charleslindsay/SMA_Driver_PCB/PCB Board Files V1/Board Top.jpg

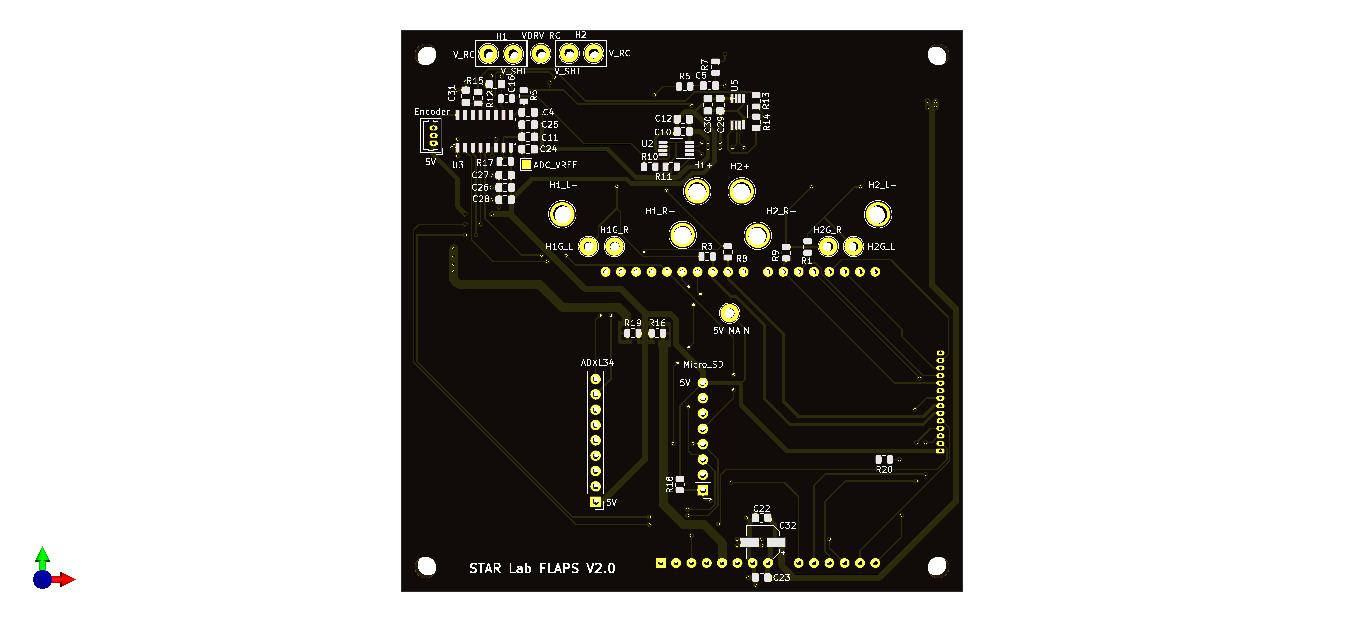
PCB Board Files V1/Board Top.jpg
