charleslindsay/SMA_Driver_PCB/BOM V2/BOM_Digikey_Order_01.11.19.xlsx

# | Quantity | Part Number | Manufacturer Part Number | Description | Customer Reference | Backorder | Unit Price | Extended Price
1 | 5 | P4.0MCT-ND | ERJ-M1WSF4M0U | RES 0.004 OHM 1% 1W 2512 |  | 0 | 0.7 | 3.50
2 | 5 | P6.0MCT-ND | ERJ-M1WSF6M0U | RES 0.006 OHM 1% 1W 2512 |  | 0 | 0.7 | 3.50
3 | 4 | NVMFS5C404NLAFT1GOSCT-ND | NVMFS5C404NLAFT1G | MOSFET N-CH 40V 370A 5DFN |  | 0 | 4.13 | 16.52
4 | 10 | 311-124CRCT-ND | RC0805FR-07124RL | RES SMD 124 OHM 1% 1/8W 0805 |  | 0 | 0.043 | 0.43
5 | 2 | 296-41265-1-ND | INA332AIDGKR | IC OPAMP INSTR 2MHZ RRO 8VSSOP |  | 0 | 1.61 | 3.22
6 | 1 | 555-1256-1-ND | UDT020A0X3-SRZ | DC DC CONVERTER 0.5-5.5V 20A |  | 0 | 17.33 | 17.33
7 | 10 | RHM1.00KAECT-ND | ESR10EZPF1001 | RES SMD 1K OHM 1% 0.4W 0805 |  | 0 | 0.146 | 1.46
8 | 5 | P24KDACT-ND | ERA-6AEB243V | RES SMD 24K OHM 0.1% 1/8W 0805 |  | 0 | 0.36 | 1.80
9 | 5 | P22KDACT-ND | ERA-6AEB223V | RES SMD 22K OHM 0.1% 1/8W 0805 |  | 0 | 0.36 | 1.80
10 | 5 | P20KDACT-ND | ERA-6AEB203V | RES SMD 20K OHM 0.1% 1/8W 0805 |  | 0 | 0.36 | 1.80
11 | 5 | P30KDACT-ND | ERA-6AEB303V | RES SMD 30K OHM 0.1% 1/8W 0805 |  | 0 | 0.36 | 1.80
12 | 5 | P33KDACT-ND | ERA-6AEB333V | RES SMD 33K OHM 0.1% 1/8W 0805 |  | 0 | 0.36 | 1.80
13 | 5 | P27KDACT-ND | ERA-6AEB273V | RES SMD 27K OHM 0.1% 1/8W 0805 |  | 0 | 0.36 | 1.80
14 | 5 | P36KDACT-ND | ERA-6AEB363V | RES SMD 36K OHM 0.1% 1/8W 0805 |  | 0 | 0.36 | 1.80
15 | 1 | MCP3208T-BI/SLCT-ND | MCP3208T-BI/SL | IC ADC 12BIT 2.7V 8CH SPI 16SOIC |  | 0 | 4.48 | 4.48
16 | 3 | 541-0.0TBCT-ND | CRCW08050000Z0EAHP | RES SMD 0 OHM JUMPER 1/2W 0805 |  | 0 | 0.25 | 0.75
17 | 6 | 718-2181-1-ND | T55D337M6R3C0012 | CAP TANT POLY 330UF 6.3V 2917 |  | 0 | 2.03 | 12.18
18 | 5 | 1276-1852-1-ND | CL21A476MQYNNNE | CAP CER 47UF 6.3V X5R 0805 |  | 0 | 0.6 | 3.00
19 | 10 | RTAN0805BKE180RCT-ND | RTAN0805BKE180R | RES 180 OHM 0.1% 1/5W 0805 |  | 0 | 0.485 | 4.85
20 | 10 | 399-7995-1-ND | C0805C103K4RACTU | CAP CER 10000PF 16V X7R 0805 |  | 0 | 0.13 | 1.30
21 | 5 | 1276-2908-1-ND | CL21A226MAQNNNE | CAP CER 22UF 25V X5R 0805 |  | 0 | 1.05 | 5.25
22 | 5 | 709-1183-1-ND | 160R15W104KV4T | CAP CER 0.1UF 16V X7R 0805 |  | 0 | 0.23 | 1.15
23 | 5 | 1276-2873-1-ND | CL21B475KOFNNNE | CAP CER 4.7UF 16V X7R 0805 |  | 0 | 0.34 | 1.70
24 | 1 | 1528-1015-ND | 1231 | ADXL345 3AXIS ACCEL BREAKOUT BRD |  | 0 | 17.5 | 17.50
25 | 1 | 1528-1462-ND | 254 | MICROSD CARD BREAKOUT 5V OR 3V |  | 0 | 7.5 | 7.50
26 | 5 | RNCF0805DTE10K0CT-ND | RNCF0805DTE10K0 | RES 10K OHM 0.5% 1/8W 0805 |  | 0 | 0.17 | 0.85
27 | 3 | WM17004-ND | 0530471410 | CONN HEADER VERT 14POS 1.25MM |  | 0 | 1.24 | 3.72
28 | 2 | WM1732-ND | 0530470310 | CONN HEADER VERT 3POS 1.25MM |  | 0 | 0.44 | 0.88
29 | 8 | 36-5006-ND | 5006 | PC TEST POINT COMPACT BLACK |  | 0 | 0.33 | 2.64
30 | 5 | PCE3947CT-ND | EEE-1VA100SR | CAP ALUM 10UF 20% 35V SMD |  | 0 | 0.31 | 1.55
31 | 1 | WM17238-ND | 0151341405 | PICOBLADE 14 CIRCUIT 450MM |  | 0 | 6.37 | 6.37
32 | 2 | Z5376-ND | XG8V-0831 | CONN HEADER VERT 8POS 2.54MM |  | 0 | 0.53 | 1.06
33 | 2 | 732-2670-ND | 61301011121 | CONN HEADER VERT 10POS 2.54MM |  | 0 | 0.89 | 1.78
34 | 2 | 732-5319-ND | 61300611121 | CONN HEADER VERT 6POS 2.54MM |  | 0 | 0.33 | 0.66
35 | 2 | WM15255-ND | 0151340303 | PICOBLADE 3 CIRCUIT 300MM |  | 0 | 2.8 | 5.60
36 | 5 | 754-1535-1-ND | AA3528VRVFS/A | LED PURPLE CLEAR SMD |  | 0 | 0.8 | 4.00
37 | 10 | RR12P100DCT-ND | RR1220P-101-D | RES SMD 100 OHM 0.5% 1/10W 0805 |  | 0 | 0.098 | 0.98
38 | 10 | 1497-1436-1-ND | XZCBD54W-8 | LED BLUE CLEAR CHIP SMD |  | 0 | 0.454 | 4.54
39 | 5 | 404-1267-1-ND | FKA1112H-TR | LED ORANGE DIFFUSED SMD |  | 0 | 0.5 | 2.50
40 | 5 | RHM220KCT-ND | ESR10EZPJ221 | RES SMD 220 OHM 5% 0.4W 0805 |  | 0 | 0.1 | 0.50
41 | 5 | 1497-1434-1-ND | XZVG54W-8 | LED GREEN CLEAR CHIP SMD |  | 0 | 0.43 | 2.15
42 | 10 | 754-1438-1-ND | APT2012ZGC | LED GREEN CLEAR CHIP SMD |  | 0 | 0.568 | 5.68
43 | 10 | 754-1791-1-ND | APT2012SECK/J3-PRV | LED RED CLEAR CHIP SMD |  | 0 | 0.397 | 3.97
44 | 3 | CT3016-ND | 282T33L502A25C2 | POT 5K OHM 1/4W PLASTIC LINEAR |  | 0 | 13.35 | 40.05
45 | 3 | 1722-1185-ND | 1930BQ | KNOB FLUTED W/SKIRT 0.250" PHEN |  | 0 | 3.59 | 10.77
46 | 3 | 1740-1151-ND | BYC8-600P,127 | DIODE GEN PURP 600V 8A TO220AC |  | 0 | 0.79 | 2.37
47 | 10 | 311-160ARCT-ND | RC0805JR-07160RL | RES SMD 160 OHM 5% 1/8W 0805 |  | 0 | 0.037 | 0.37
 |  |  |  |  |  |  | Total | 221.21
