charleslindsay/SMA_Driver_PCB/BOM V2/BOM_Digikey_Order_01.30.19.xlsx

# | Quantity | Part Number | Manufacturer Part Number | Description | Customer Reference | Backorder | Unit Price | Extended Price
1 | 1 | WM17238-ND | 0151341405 | PICOBLADE 14 CIRCUIT 450MM |  | 0 | 6.37 | 6.37
2 | 1 | Q1193-ND | QADA-50-12-1401 | AC/DC DESKTOP ADAPTER 12V 50W |  | 0 | 18.73 | 18.73
3 | 1 | T1247-C13-JP-ND | AC-C13 JP | CORD NEMA5-15P - IEC 320-C13 6' |  | 0 | 5.81 | 5.81
4 | 1 | WM17239-ND | 0151341406 | CABLE ASSY RECT 14POS SKT TO SKT |  | 0 | 6.75 | 6.75
