charleslindsay/SMA_Driver_PCB/BOM V2/FLAPS BOM V2.0 (1xPCB).xlsx

Quantity | Ref | Value | Order Link | Footprint | Component | Price per comp | Total Price
2 | R2,R4 | 4m | https://www.digikey.com/product-detail/en/panasonic-electronic-components/ERJ-M1WSF4M0U/P4.0MCT-ND/300470 | Resistor_SMD:R_2512_6332Metric_Pad1.52x3.35mm_HandSolder | Resistor
 | " | 6m | https://www.digikey.com/product-detail/en/panasonic-electronic-components/ERJ-M1WSF6M0U/P6.0MCT-ND/966294
4 | Q1,Q2,Q3,Q4 | Q_NMOS_GDS | https://www.digikey.com/product-detail/en/on-semiconductor/NVMFS5C404NLAFT1G/NVMFS5C404NLAFT1GOSCT-ND/7066790 | custom:SO-8FL_v2 | N-MOSFET transistor, gate/drain/source
4 | R3,R8,R1,R9 | 125 | https://www.digikey.com/product-detail/en/yageo/RC0805FR-07124RL/311-124CRCT-ND/730526 | Resistor_SMD:R_0805_2012Metric | Resistor
2 | U2 | INA332 | https://www.digikey.com/product-detail/en/texas-instruments/INA332AIDGKR/296-41265-1-ND/5222729 | Package_SO:VSSOP-8_3.0x3.0mm_P0.65mm
1 | U1 | UDT020A0X3-SRZ | https://www.digikey.com/product-detail/en/ge-critical-power/UDT020A0X3-SRZ/555-1256-1-ND/2665527 | custom:UDT020A0X3-SRZ
2 | R11,R14 | 1k | https://www.digikey.com/product-detail/en/rohm-semiconductor/ESR10EZPF1001/RHM1.00KAECT-ND/1983804 | Resistor_SMD:R_0805_2012Metric | Resistor
2 | R10,R13 | 24k | https://www.digikey.com/product-detail/en/panasonic-electronic-components/ERA-6AEB243V/P24KDACT-ND/1465980 | Resistor_SMD:R_0805_2012Metric | Resistor
 | " | 22k | https://www.digikey.com/product-detail/en/panasonic-electronic-components/ERA-6AEB223V/P22KDACT-ND/1465979
 | " | 20k | https://www.digikey.com/product-detail/en/panasonic-electronic-components/ERA-6AEB203V/P20KDACT-ND/1465978
 | " | 30k | https://www.digikey.com/product-detail/en/panasonic-electronic-components/ERA-6AEB303V/P30KDACT-ND/1465982
 | " | 33k | https://www.digikey.com/product-detail/en/panasonic-electronic-components/ERA-6AEB333V/P33KDACT-ND/1465983
 | " | 27k | https://www.digikey.com/product-detail/en/panasonic-electronic-components/ERA-6AEB273V/P27KDACT-ND/1465981
 | " | 36k | https://www.digikey.com/product-detail/en/panasonic-electronic-components/ERA-6AEB363V/P36KDACT-ND/1465984
1 | R12 | 30k | https://www.digikey.com/product-detail/en/panasonic-electronic-components/ERA-6AEB303V/P30KDACT-ND/1465982 | Resistor_SMD:R_0805_2012Metric | Resistor
2 | C4,C16 | 1uF | https://www.digikey.com/product-detail/en/kemet/C0805C105J4RACTU/399-8001-1-ND/3471724 | Capacitor_SMD:C_0805_2012Metric_Pad1.15x1.40mm_HandSolder | Unpolarized capacitor
2 | R5,R7 | 15.8k | https://www.digikey.com/product-detail/en/panasonic-electronic-components/ERA-6AEB1582V/P15.8KDACT-ND/3074972 | Resistor_SMD:R_0805_2012Metric | Resistor
1 | U3 | MCP3208 | https://www.digikey.com/product-detail/en/microchip-technology/MCP3208T-BI-SL/MCP3208T-BI-SLCT-ND/8628836 | digikey-footprints:SOIC-16_W3.90mm | A/D Converter, 12-Bit, 8-Channel, SPI Interface , 2.7V-5.5V
3 | R16,R17,R19 | 0 | https://www.digikey.com/product-detail/en/vishay-dale/CRCW08050000Z0EAHP/541-0.0TBCT-ND/2222831 | Resistor_SMD:R_0805_2012Metric | Resistor
8 | C13-21 | 330u | https://www.digikey.com/product-detail/en/vishay-sprague/T55D337M6R3C0012/718-2181-1-ND/6230411 | Capacitor_Tantalum_SMD:CP_EIA-7343-43_Kemet-X_Pad2.25x2.55mm_HandSolder | Unpolarized capacitor
2 | C6,C7 | 47uF | https://www.digikey.com/product-detail/en/samsung-electro-mechanics/CL21A476MQYNNNE/1276-1852-1-ND/3889938 | Capacitor_SMD:C_0805_2012Metric_Pad1.15x1.40mm_HandSolder | Unpolarized capacitor
1 | R6 | 180 | https://www.digikey.com/product-detail/en/stackpole-electronics-inc/RTAN0805BKE180R/RTAN0805BKE180RCT-ND/6602252 | Resistor_SMD:R_0805_2012Metric | Resistor
3 | C5,C11,C28 | 10n | https://www.digikey.com/product-detail/en/kemet/C0805C103K4RACTU/399-7995-1-ND/3471718 | Capacitor_SMD:C_0805_2012Metric_Pad1.15x1.40mm_HandSolder | Unpolarized capacitor
3 | C1-3 | 22uF | https://www.digikey.com/product-detail/en/samsung-electro-mechanics/CL21A226MAQNNNE/1276-2908-1-ND/3890994 | Capacitor_SMD:C_0805_2012Metric_Pad1.15x1.40mm_HandSolder | Unpolarized capacitor
4 | C10,C23,C24,C27 | 100n | https://www.digikey.com/product-detail/en/johanson-dielectrics-inc/160R15W104KV4T/709-1183-1-ND/1859515 | Capacitor_SMD:C_0805_2012Metric_Pad1.15x1.40mm_HandSolder | Unpolarized capacitor
3 | C12,C25,C26 | 4.7u | https://www.digikey.com/product-detail/en/samsung-electro-mechanics/CL21B475KOFNNNE/1276-2873-1-ND/3890959 | Capacitor_SMD:C_0805_2012Metric_Pad1.15x1.40mm_HandSolder | Unpolarized capacitor
1 | A2 | ADXL34_Accelerometer | https://www.digikey.com/product-detail/en/adafruit-industries-llc/1231/1528-1015-ND/4990764 | Connector_PinHeader_2.54mm:PinHeader_1x09_P2.54mm_Vertical
1 | U4 | MicroSD_Breakout_ADF | https://www.digikey.com/products/en?mpart=254&v=1528 | Connector_PinHeader_2.54mm:PinHeader_1x08_P2.54mm_Vertical
1 | R18 | 10k | https://www.digikey.com/product-detail/en/stackpole-electronics-inc/RNCF0805DTE10K0/RNCF0805DTE10K0CT-ND/2687083 | Resistor_SMD:R_0805_2012Metric | Resistor
1 | J1 | Human_Interface_Tether | https://www.digikey.com/products/en/connectors-interconnects/rectangular-connectors-headers-male-pins/314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 | Connector_Molex:Molex_PicoBlade_53047-2810_1x14_P1.25mm_Vertical | Generic connector, single row, 01x14, script generated (kicad-library-utils/schlib/autogen/connector/)
1 | J2 | RM08V_Conn | https://www.digikey.com/products/en/connectors-interconnects/rectangular-connectors-headers-male-pins/314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 | Connector_Molex:Molex_PicoBlade_53047-0610_1x03_P1.25mm_Vertical | Generic connector, single row, 01x03, script generated (kicad-library-utils/schlib/autogen/connector/)
8 | TP6, TP4, TP14, TP19, TP7, TP17, TP20, TP21 | Gate_2 | https://www.digikey.com/product-detail/en/keystone-electronics/5006/36-5006-ND/255330 | TestPoint:TestPoint_Loop_D2.60mm_Drill1.6mm_Beaded | test point
3 | C8,C9,C32 | 10uF | https://www.digikey.com/product-detail/en/panasonic-electronic-components/EEE-1VA100SR/PCE3947CT-ND/766323 | Capacitor_SMD:CP_Elec_5x5.3 | Unpolarized capacitor
2 | C30,C22 | 4.7u | https://www.digikey.com/product-detail/en/samsung-electro-mechanics/CL21B475KOFNNNE/1276-2873-1-ND/3890959 | Capacitor_SMD:C_0805_2012Metric_Pad1.15x1.40mm_HandSolder | Unpolarized capacitor
1 | NA | Tether Cable | https://www.digikey.com/product-detail/en/molex-llc/0151341405/WM17238-ND/7929163
2 | NA | 8 pin header | https://www.digikey.com/products/en?keywords=Z5376-ND
1 | NA | 10 pin header | https://www.digikey.com/products/en?keywords=732-2670-ND
1 | NA | 6 pin header | https://www.digikey.com/products/en?keywords=732-5319-ND
1 | NA | Encoder Cable | https://www.digikey.com/products/en/cable-assemblies/rectangular-cable-assemblies/450?k=015134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
