charleslindsay/SMA_Driver_PCB/SMA_Driver_V1.kicad_pcb

## KiCad design SMA_Driver_V1.kicad_pcb (2019-01-10)

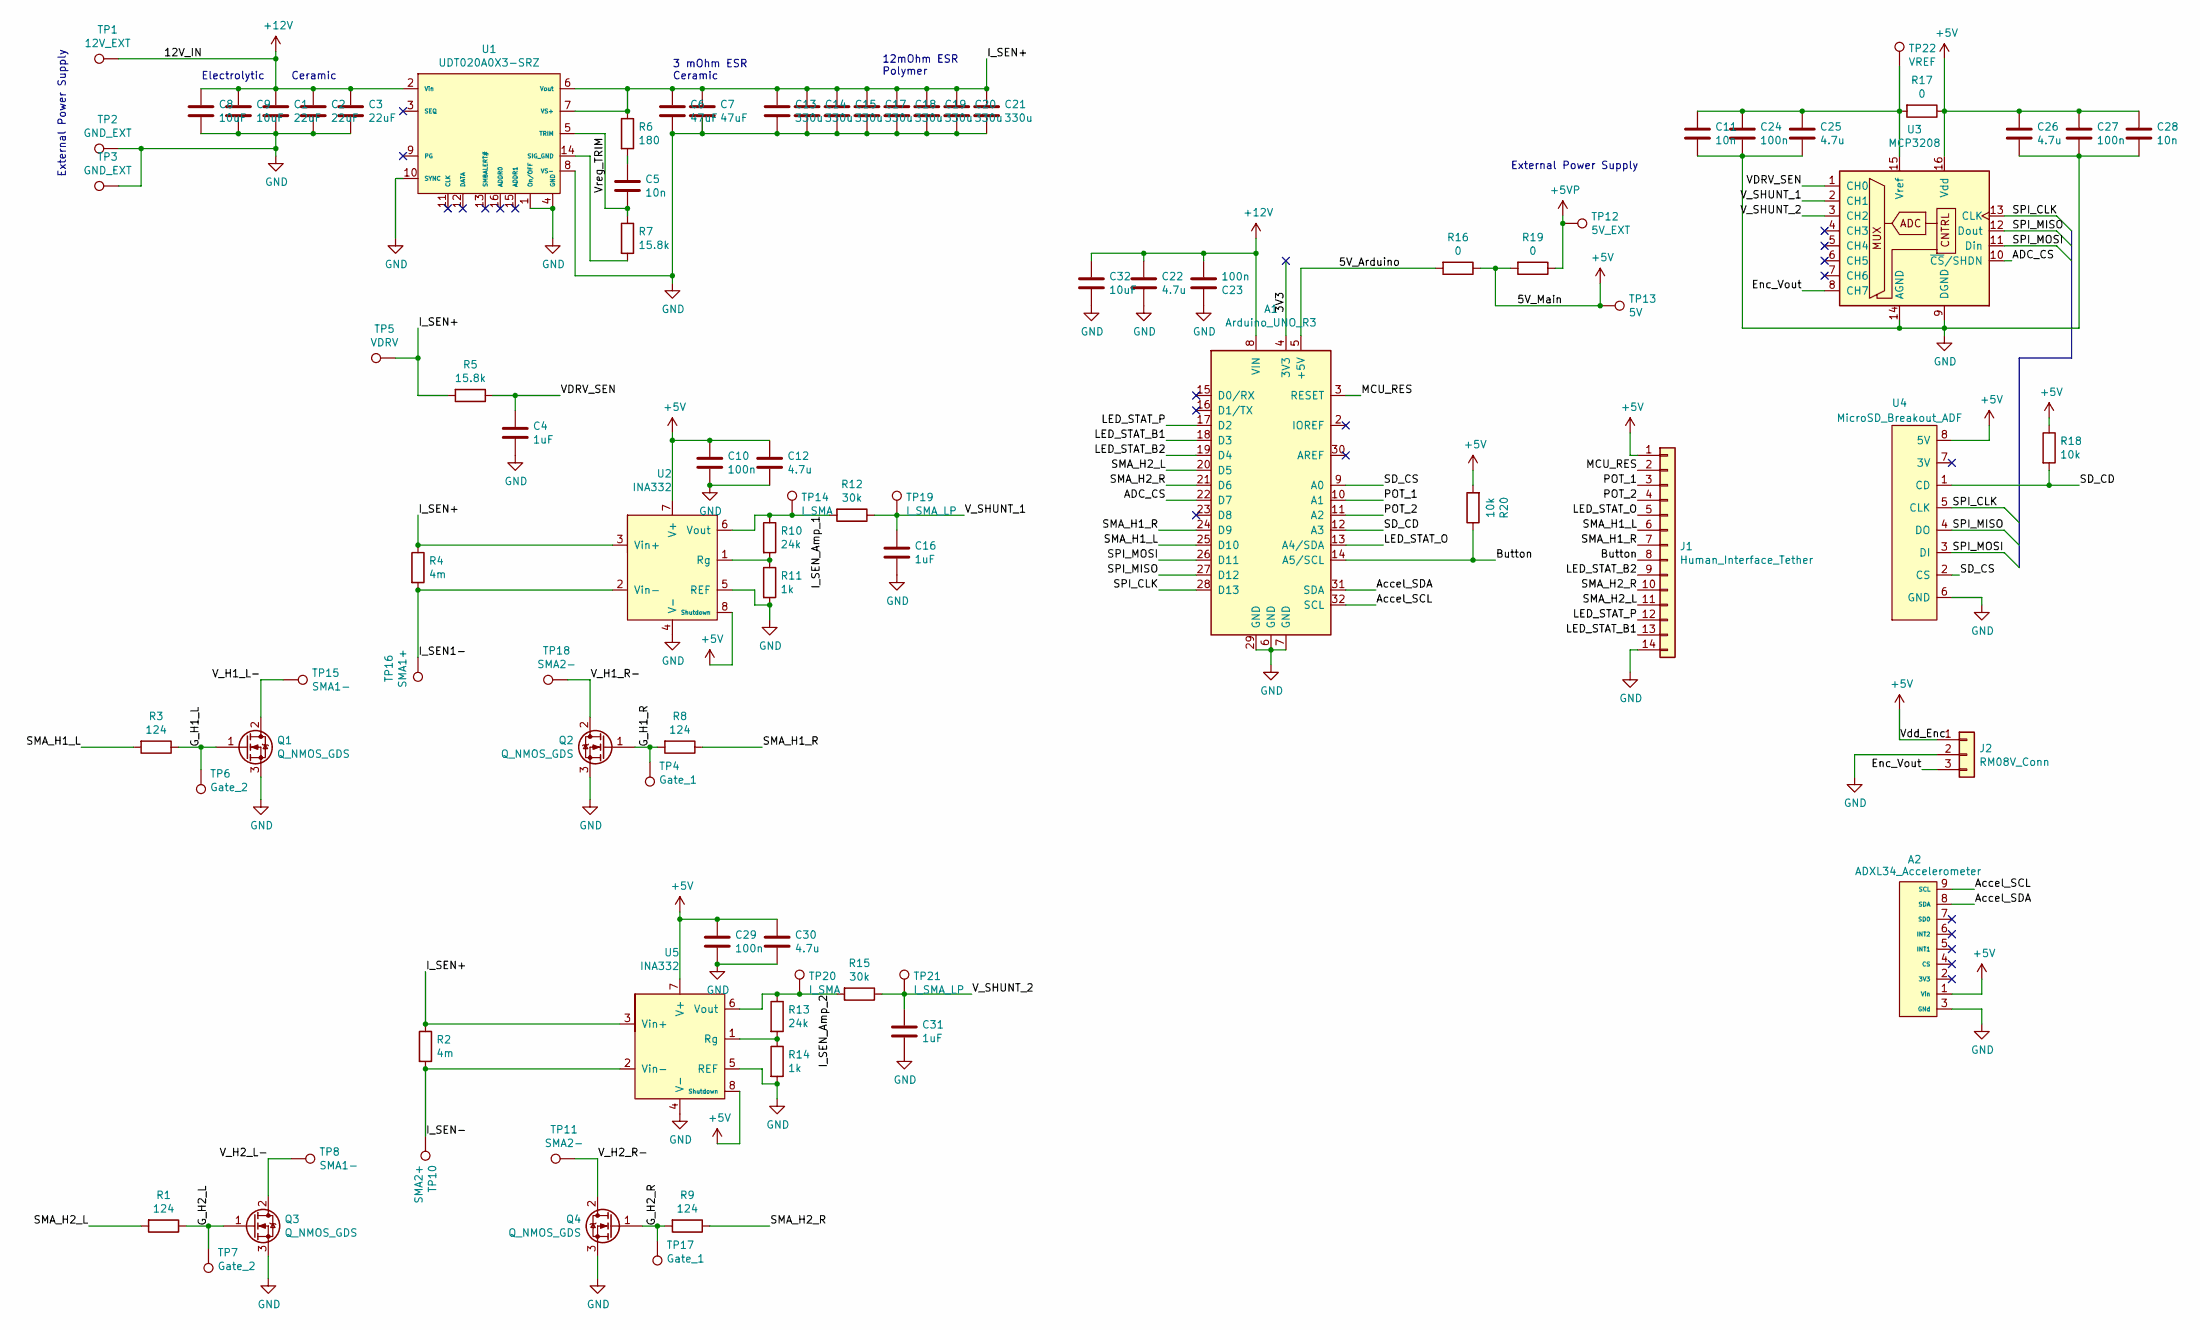
[picture p2: schematic SMA_Driver_V1.sch, SMA Driver]

Parts:
A1: Arduino_UNO_R3
A2: ADXL34_Accelerometer; PinHeader_1x09_P2.54mm_Vertical
C1, C2, C3: 22uF; C_0805_2012Metric_Pad1.15x1.40mm_HandSolder
C4, C16, C31: 1uF; C_0805_2012Metric_Pad1.15x1.40mm_HandSolder
C5, C11, C28: 10n; C_0805_2012Metric_Pad1.15x1.40mm_HandSolder
C6, C7: 47uF; C_0805_2012Metric_Pad1.15x1.40mm_HandSolder
C8, C9, C32: 10uF; CP_Elec_5x5.3
C10, C23, C24, C27, C29: 100n; C_0805_2012Metric_Pad1.15x1.40mm_HandSolder
C12, C22, C25, C26, C30: 4.7u; C_0805_2012Metric_Pad1.15x1.40mm_HandSolder
C13, C14, C15, C17, C18, C19, C20, C21: 330u; CP_EIA-7343-43_Kemet-X_Pad2.25x2.55mm_HandSolder
J1: Human_Interface_Tether; Molex_PicoBlade_53047-2810_1x14_P1.25mm_Vertical
J2: RM08V_Conn; Molex_PicoBlade_53047-0610_1x03_P1.25mm_Vertical
Q1, Q2, Q3, Q4: Q_NMOS_GDS; SO-8FL_v2
R1, R3, R8, R9: 124; R_0805_2012Metric
R2, R4: 4m; R_2512_6332Metric_Pad1.52x3.35mm_HandSolder
R5, R7: 15.8k; R_0805_2012Metric
R6: 180; R_0805_2012Metric
R10, R13: 24k; R_0805_2012Metric
R11, R14: 1k; R_0805_2012Metric
R12, R15: 30k; R_0805_2012Metric
R16, R17, R19: 0; R_0805_2012Metric
R18, R20: 10k; R_0805_2012Metric
TP1: 12V_EXT; TestPoint_Pad_4.0x4.0mm
TP2, TP3: GND_EXT; TestPoint_Pad_4.0x4.0mm
TP4, TP17: Gate_1; TestPoint_Loop_D2.60mm_Drill1.6mm_Beaded
TP5: VDRV; TestPoint_Loop_D2.60mm_Drill1.6mm_Beaded
TP6, TP7: Gate_2; TestPoint_Loop_D2.60mm_Drill1.6mm_Beaded
TP8, TP15: SMA1-; TestPoint_Plated_Hole_D3.0mm
TP10: SMA2+; TestPoint_Plated_Hole_D3.0mm
TP11, TP18: SMA2-; TestPoint_Plated_Hole_D3.0mm
TP12: 5V_EXT; TestPoint_Pad_4.0x4.0mm
TP13: 5V; TestPoint_Loop_D2.60mm_Drill1.6mm_Beaded
TP14, TP20: I_SMA; TestPoint_Loop_D2.60mm_Drill1.6mm_Beaded
TP16: SMA1+; TestPoint_Plated_Hole_D3.0mm
TP19, TP21: I_SMA_LP; TestPoint_Loop_D2.60mm_Drill1.6mm_Beaded
TP22: VREF; TestPoint_Pad_1.5x1.5mm
U1: UDT020A0X3-SRZ
U2, U5: INA332; VSSOP-8_3.0x3.0mm_P0.65mm
U3: MCP3208; SOIC-16_W3.90mm
U4: MicroSD_Breakout_ADF; PinHeader_1x08_P2.54mm_Vertical

Connections:
+5V: A2.1 (Vin), C10.1, C12.1, C26.1, C27.1, C28.1, C29.1, C30.1, J1.1, J2.1, R16.1, R17.1, R18.1, R19.2, R20.2, TP13.1, U2.7 (V+), U2.8 (Shutdown), U3.16 (Vdd), U4.8 (5V), U5.7 (V+), U5.8 (Shutdown)
+5VP: R19.1, TP12.1
+12V: A1.8 (VIN), C1.1, C2.1, C3.1, C8.1, C9.1, C22.1, C23.2, C32.1, TP1.1, U1.2 (Vin)
/3V3: A1.4 (3V3)
/5V_Arduino: A1.5 (+5V), R16.2
/ADC_CS: A1.22 (D7), U3.10 (~CS~/SHDN)
/Accel_SCL: A1.32 (SCL), A2.9 (SCL)
/Accel_SDA: A1.31 (SDA), A2.8 (SDA)
/Button: A1.14 (A5/SCL), J1.8, R20.1
/Enc_Vout: J2.3, U3.8 (CH7)
/G_H1_L: Q1.1 (G), R3.1, TP6.1
/G_H1_R: Q2.1 (G), R8.2, TP4.1
/G_H2_L: Q3.1 (G), R1.1, TP7.1
/G_H2_R: Q4.1 (G), R9.2, TP17.1
/I_SEN1-: R4.2, TP16.1, U2.2 (Vin-)
/I_SEN+: C6.1, C7.1, C13.1, C14.1, C15.1, C17.1, C18.1, C19.1, C20.1, C21.1, R2.1, R4.1, R5.2, R6.1, TP5.1, U1.6 (Vout), U1.7 (VS+), U2.3 (Vin+), U5.3 (Vin+)
/I_SEN-: R2.2, TP10.1, U5.2 (Vin-)
/I_SEN_Amp_1: R10.1, R12.2, TP14.1, U2.6 (Vout)
/I_SEN_Amp_2: R13.1, R15.2, TP20.1, U5.6 (Vout)
/LED_STAT_B1: A1.18 (D3), J1.13
/LED_STAT_B2: A1.19 (D4), J1.9
/LED_STAT_O: A1.13 (A4/SDA), J1.5
/LED_STAT_P: A1.17 (D2), J1.12
/MCU_RES: A1.3 (RESET), J1.2
/POT_1: A1.10 (A1), J1.3
/POT_2: A1.11 (A2), J1.4
/SD_CD: A1.12 (A3), R18.2, U4.1 (CD)
/SD_CS: A1.9 (A0), U4.2 (CS)
/SMA_H1_L: A1.25 (D10), J1.6, R3.2
/SMA_H1_R: A1.24 (D9), J1.7, R8.1
/SMA_H2_L: A1.20 (D5), J1.11, R1.2
/SMA_H2_R: A1.21 (D6), J1.10, R9.1
/SPI_CLK: A1.28 (D13), U3.13 (CLK), U4.5 (CLK)
/SPI_MISO: A1.27 (D12), U3.12 (Dout), U4.4 (DO)
/SPI_MOSI: A1.26 (D11), U3.11 (Din), U4.3 (DI)
/VDRV_SEN: C4.1, R5.1, U3.1 (CH0)
/V_H1_L-: Q1.2 (D), TP15.1
/V_H1_R-: Q2.2 (D), TP18.1
/V_H2_L-: Q3.2 (D), TP8.1
/V_H2_R-: Q4.2 (D), TP11.1
/V_SHUNT_1: C16.1, R12.1, TP19.1, U3.2 (CH1)
/V_SHUNT_2: C31.1, R15.1, TP21.1, U3.3 (CH2)
/Vreg_TRIM: C5.2, R7.1, U1.5 (TRIM)
GND: A1.6 (GND), A1.7 (GND), A1.29 (GND), A2.3 (GNd), C1.2, C2.2, C3.2, C4.2, C6.2, C7.2, C8.2, C9.2, C10.2, C11.2, C12.2, C13.2, C14.2, C15.2, C16.2, C17.2, C18.2, C19.2, C20.2, C21.2, C22.2, C23.1, C24.2, C25.2, C26.2, C27.2, C28.2, C29.2, C30.2, C31.2, C32.2, J1.14, J2.2, Q1.3 (S), Q2.3 (S), Q3.3 (S), Q4.3 (S), R11.2, R14.2, TP2.1, TP3.1, U1.1 (On/OFF), U1.4 (GND), U1.8 (VS-), U1.10 (SYNC), U2.4 (V-), U2.5 (REF), U3.9 (DGND), U3.14 (AGND), U4.6 (GND), U5.4 (V-), U5.5 (REF)
unnamed: C5.1, R6.2
unnamed: C11.1, C24.1, C25.1, R17.2, TP22.1, U3.15 (Vref)
unnamed: R7.2, U1.14 (SIG_GND)
unnamed: R10.2, R11.1, U2.1 (Rg)
unnamed: R13.2, R14.1, U5.1 (Rg)

Notes on the sheet:
12mOhm ESR Polymer
3 mOhm ESR Ceramic
Ceramic
External Power Supply
Electrolytic

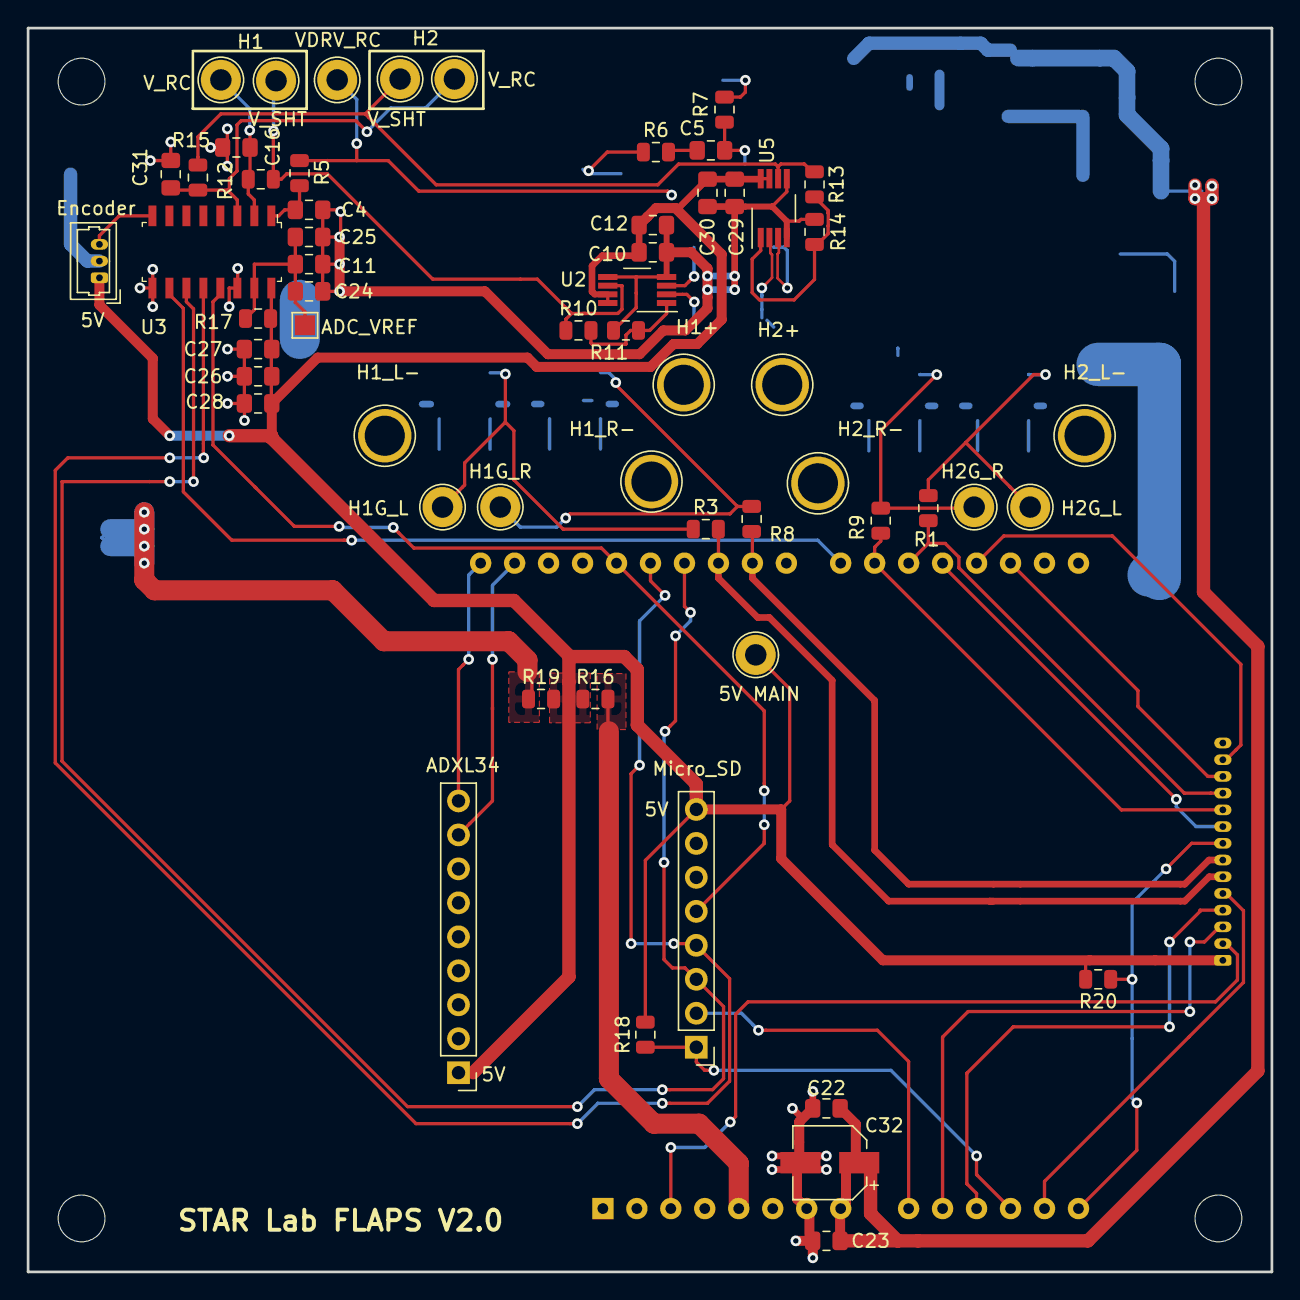
[picture p3: board SMA_Driver_V1.kicad_pcb from above]

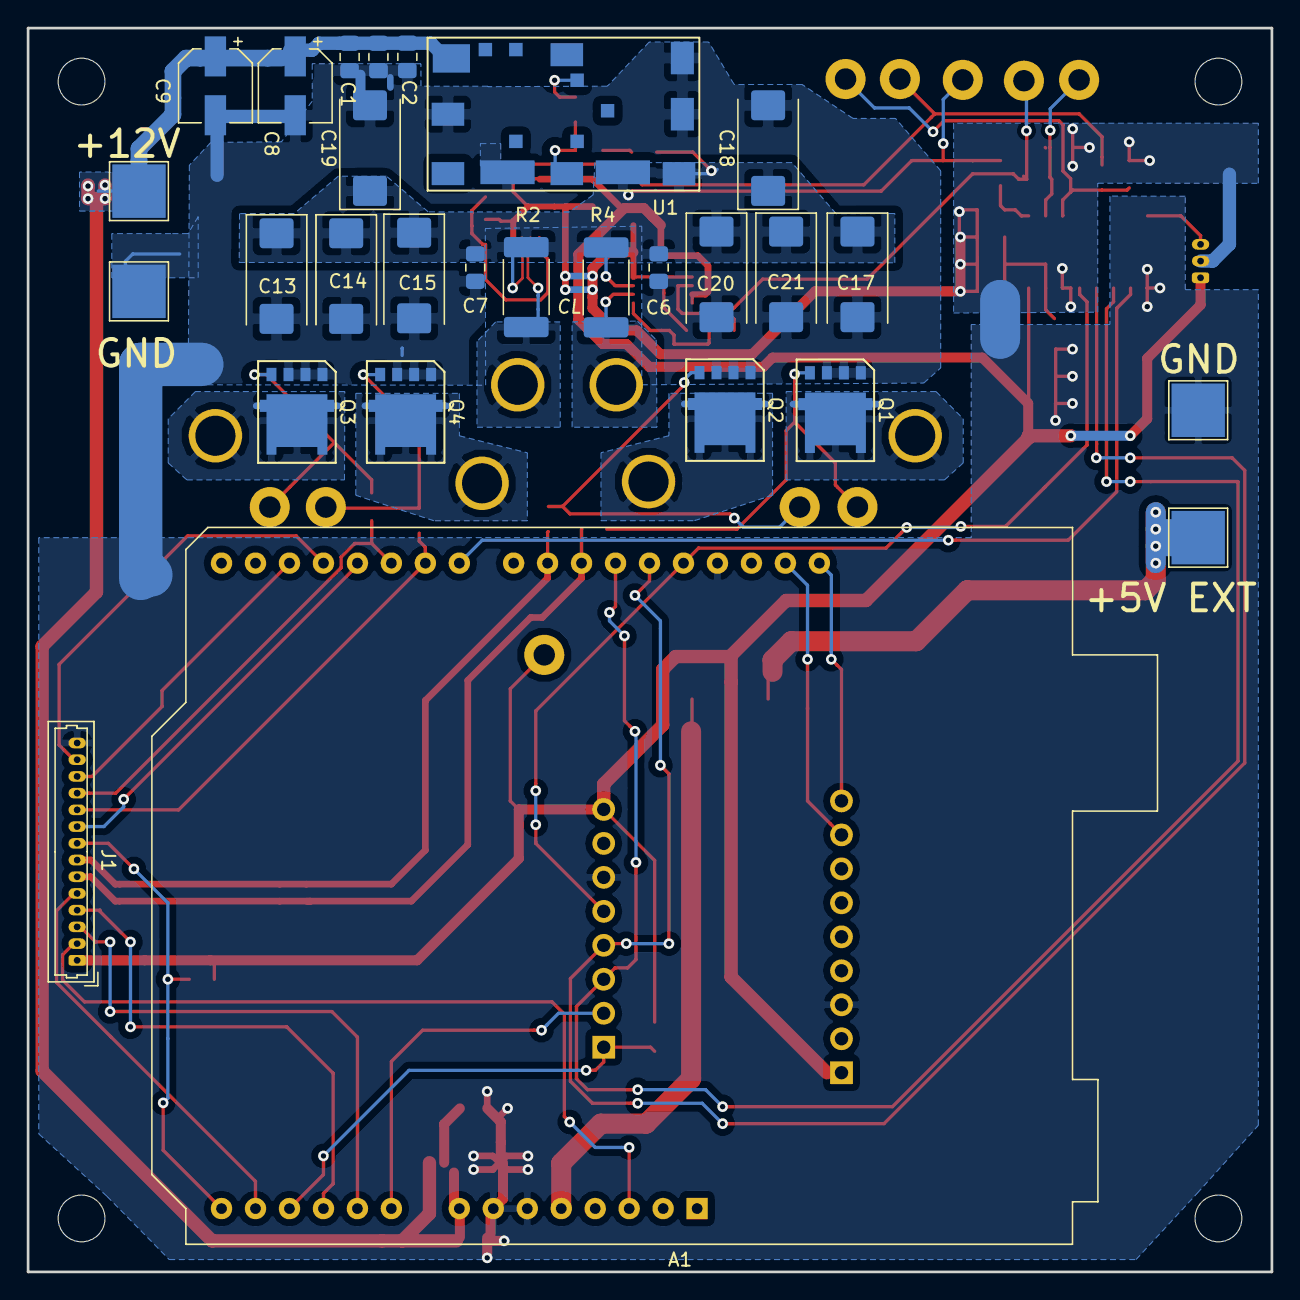
[picture p4: board SMA_Driver_V1.kicad_pcb from below]

Board: 2 copper layers, 93.0 x 93.0 mm, 86 parts (28 on the bottom side), 48 nets.
