charleslindsay/SMA_Driver_PCB/(commit log)

2018-12-31 second commmit
    [BOM_DigiKey_Order_11.23.18.xlsx, BOM_SMA_Driver_V1.0_1xPCB_Cost.xlsx, BOM_SMA_Driver_V1.0_Order_3xPCBs.xlsx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]
2018-12-31 undo test
    [BOM_SMA_Driver_V1.0_1xPCB_Cost.xlsx]
2019-01-01 fixed notes on 'SMA Driver V1 changes for V2'
    [SMA_Driver_V1.kicad_pcb, SMA_Driver_V1.sch]
2019-01-03 PCB Rev 2.0 Fixed issues on PCB changes for V2 doc
    [SMA_Driver_V1.kicad_pcb, SMA_Driver_V1.sch]
2019-01-07 added components for button, final draft 1
    [SMA_Driver_V1.kicad_pcb, SMA_Driver_V1.sch]
2019-01-07 Final Board V2.0 after run DMC check completed with no errors
    [SMA_Driver_V1.kicad_pcb, SMA_Driver_V1.sch]
2019-01-10 Final PCB version, sent to PCBWay for order on 1.10.19
    [SMA_Driver_V1-B.Cu.gbr, SMA_Driver_V1-B.Mask.gbr, SMA_Driver_V1-B.Paste.gbr, SMA_Driver_V1-B.SilkS.gbr, SMA_Driver_V1-Edge.Cuts.gbr, SMA_Driver_V1-F.Cu.gbr, SMA_Driver_V1-F.Mask.gbr, SMA_Driver_V1-F.Paste.gbr]
2019-01-12 changed RC filter for Vin to have same resistor value as amp filter to eliminate common mode noise affecting comparison between Vin and Vshunt in code
    [SMA_Driver_V1.sch]
2019-06-06 Misc Changes, and OMIT R20 to fix SDA tied to A4 issue
    [BOM_DigiKey_Order_11.23.18.xlsx, BOM_Digikey_Order_01.11.19.xlsx, BOM_Digikey_Order_01.30.19.xlsx, BOM_SMA_Driver_V1.0_Order_3xPCBs.xlsx, FLAPS BOM V2.0 (1xPCB).xlsx, FLAPS BOM V2.0 (order for 2 boards + use parts from V1 order).xlsx, FLAPS BOM V2.0.xlsx, SMA_Driver_V1.sch]
